bhavanasrinamthabad1809-hub/stargazing/README.md

#  Stargazing

**A panda-shaped task clock that nags me when it's time to start, yells when time's up, and gives me a star if I actually did the thing.**

## Why I made this

I am a professional procrastinator.

I don't mean "oh, I put things off a little." I mean I sit down to read a book for 30 minutes, and somehow it is two hours later and I have watched a video about how bridges are built. Phone alarms don't work on me, because I swipe them away without even waking up properly. To-do apps don't work either, because opening an app is already a task I'm avoiding.

So I asked myself: what if the thing that nags me was a *physical object* that sits on my desk, can't be swiped away, and is kind of cute so I don't hate it?

That's Stargazing. Every task has a **start time** and a **deadline**. At the start time it beeps at me. At the deadline it sounds an alarm. In between, I either press **DONE** and get a star in my little night sky, or I press **NOT DONE** and get nothing. It turns out I will do a surprising amount of work for a tiny pixel star.

---

## What it does

- Shows the **time and date** like a normal desk clock.
- Holds up to **10 tasks**, each with a name, a start time and a deadline.
- **Beeps at the start time** (three rising notes, repeated every minute until I press START).
- Shows a **countdown and a progress bar** while a task is running.
- Sounds a **siren at the deadline** until I press DONE or NOT DONE.
- Adds a **star to my star sky** for every task I finish, and the stars are saved even when it's unplugged.
- Lets me **add tasks from my phone** over Wi-Fi, with no app to install.
- Keeps the correct time even when the power is off, thanks to a battery-backed clock chip.
- Repeats my tasks every day, so I only have to type them in once.

**The three buttons** (left to right on the panda's belly): start not done done
Pressing `done` on the home screen shows my star sky.

---

## How it works 

1. I load my tasks from my phone 
2. The ESP32 keeps checking the time from the RTC.
3. When a task's start time arrives → **start alert**.
4. I press **START** → countdown begins.
5. When the deadline arrives → **siren**.
6. I press **DONE** ( +1) or **NOT DONE** (no star), and it moves on to the next task.

What if I ignore it?
- I never press START: after 10 minutes the task counts as **missed**.
- I ignore the siren: after 2 minutes it counts as **not done**.

(It really does not let me get away with anything. That's the point.)

###  pcb
schematic for my pcb 


pcb 


3d model of my pcb


## How the firmware works

The code is written in Arduino C++ 

**Main idea:**:

| State | What's happening | How it ends |
|---|---|---|
| WAITING | Home screen: time, date, next task | A task's start time arrives, or I press DONE to see the star sky |
| START_ALERT | Beeping, "TIME TO START" | I press START, or 10 minutes pass (missed) |
| RUNNING | Countdown and progress bar | Deadline arrives, or I press DONE / NOT DONE early |
| DEADLINE | Siren, "TIME'S UP!" | I press DONE or NOT DONE, or 2 minutes pass (not done) |
| RESULT | "GREAT JOB!" or "NOT DONE" for 3 seconds | Timer ends, back to `WAITING` |
| SKY | My stars | 5 seconds, or any button |

**cad time:**:
bottom case 



different view 



with pcb view



top case 



top view 



top back side view 



full box view 



**First time / changing tasks**
1. Unplug the clock, then plug it in **while holding START**.
2. On your phone, join the Wi-Fi **TaskClock** (password **panda1234**, you can change both in the code).
3. Open  in your browser.
4. Add your tasks (name, start, deadline) and press **Save to clock**.
5. It restarts by itself and you're done.

**Every day**
Just look at it. It will tell you what to do

## bill of materials 

| Component | Quantity | Description | Source | Price |
| --- | ---: | --- | --- | ----: |
| ESP32-C3 supermini | 1 | Microcontroller | [link](https://www.amazon.in/ESP32-Mini-Development-Board-Compatibility/dp/B0GQC8T6HV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) | $8.21 |
| OLED Display | 1 | Small display | [link](https://www.amazon.in/gp/product/B07Q7VZ716/ref=sw_img_1?smid=&psc=1) |$3.16 |
| 10K Resistor | 1 | Pull-up resistor | [link](https://robocraze.com/products/10k-resistor-pack-of-10) | $1|
| switches  | 3 | User input buttons  | [link](https://www.amazon.in/gp/product/B0D9NGL25F/ref=ox_sc_act_title_6?smid=AJ6SIZC8YQDZX&psc=1) | $3.25 |
|  buzzer | 1 | alarm  | [link](https://robu.in/product/1-month-warranty-1248/) | $0.53 |
| PCB | 1 | Custom-designed PCB | [link](https://jlcpcb.com/)  | $4|
| coin  battery | 1 | to work without the connection  | [Link](https://www.amazon.in/Microusb-Compatible-LIR2032-Rechargeable-Lithium/dp/B0DVCFHYPP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) | $4.04 |
| rtc module | 1 | time tracking | [Link](https://robu.in/product/ds3231-rtc-module-precise-real-time-clock-i2c-at24c32/) | $1.32 |
| S8050 transistor | 1 | works as a switch to buzzer | [Link]() |  |
| 1k resistor | 1 | to work without the connection  | [Link]() |  |
| jumper wires | 1 | to solder with rtc  | [Link](https://robu.in/product/male-to-female-jumper-wires-40pcs-20cm/) | $0.53 |
| 1N4148 diode | 1 | to solder with rtc  | [Link](https://robu.in/product/1n4148-multicomp-pro-1n4148-diode-ultrafast-recovery-150ma-75v-do-204ah-2-2/) | $0.16 |
| m3screws | 1 | to solder with rtc  | [Link]() |  |
| pcb case | 1 | to place pcb  | [Link](https://robu.in/product/numaker-abs-filament-pure-white-1-75-mm-1-kg/) | $8.21  |

## Made with

KiCad, Onshape, , Arduino IDE, and a lot of avoiding my homework.
