bhavanasrinamthabad1809-hub/stargazing/BOM.csv

Item | Qty | Supplier | Cost/item | Total Cost | link
fliament | 1 | robu | $8.21 | $8.21 | https://robu.in/product/numaker-abs-filament-pure-white-1-75-mm-1-kg/
esp32-c3 supermini | 1 | amazon | $4.21 | $4.21 | https://www.amazon.in/ESP32-Mini-Development-Board-Compatibility/dp/B0GQC8T6HV
buzzer | 1 | robu | $0.53 | $0.53 | https://robu.in/product/1-month-warranty-1248/
display | 1 | amazon | $3.16 | $3.16 | https://www.amazon.in/gp/product/B07Q7VZ716/ref=sw_img_1?smid=&psc=1
rtc module | 1 | robu | $1.32 | $1.32 | https://robu.in/product/ds3231-rtc-module-precise-real-time-clock-i2c-at24c32/
resistor | 1 | robu | $0.16 | $0.16 | https://robu.in/product/1n4148-multicomp-pro-1n4148-diode-ultrafast-recovery-150ma-75v-do-204ah-2-2/
pcb | 1 | jlcpcb | $4.00 | $4.00 | https://jlcpcb.com/
jumper wires | 1 | robu | $0.53 | $0.53 | https://robu.in/product/male-to-female-jumper-wires-40pcs-20cm/
resistor diode 6pin m3 screws | 1 | local vendor he dont have website | $9.00 | $9.00 | https://robu.in/product/male-to-female-jumper-wires-40pcs-20cm
Estimated total shipping | 1 |  |  | $0.00
