bhavanasrinamthabad1809-hub/stargazing/cadweek4/Part Studio 1 bottom case.step

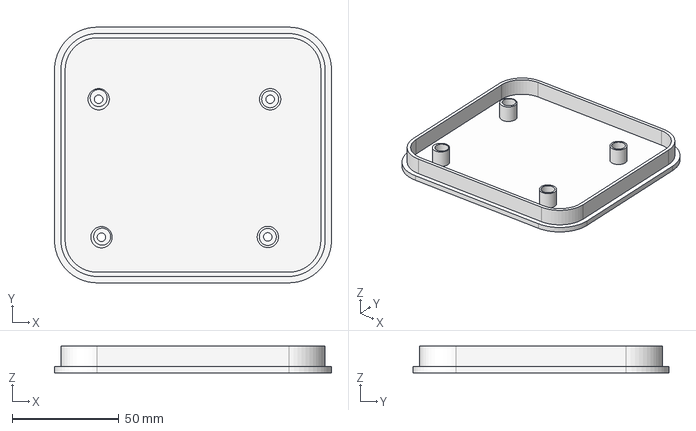
[picture p1: CAD file, 2026-11-02]
cadweek4/Part Studio 1 bottom case.step
130.0 x 120.0 x 12.6 mm
