bhavanasrinamthabad1809-hub/stargazing/procastination/procastination.step

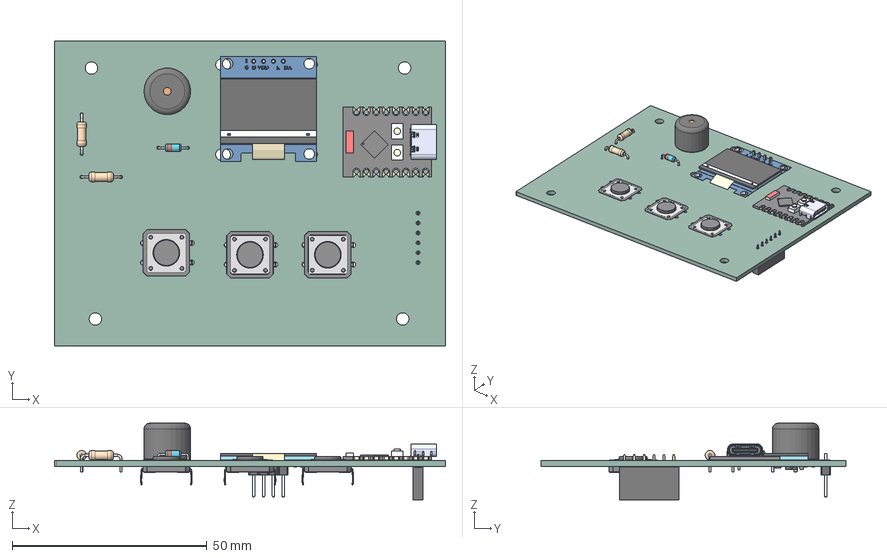
[picture p2: CAD file, 2026-11-01]
procastination/procastination.step
100.5 x 78.5 x 19.7 mm
Push Button x 3
R_Axial_DIN0207_L63mm_D25mm_P1016mm_Horizontal x 2
Board c3mini
USB C
components (other)^ESP32-C3 SuperMini
D_DO-35_SOD27_P7.62mm_Horizontal
4x1 male header pins v2
Buzzer_12x95RM76
PinSocket_1x06_P2.54mm_Vertical
pro6897_PCB
