bhavanasrinamthabad1809-hub/stargazing/cadweek4/Part Studio 1 - left ear.step

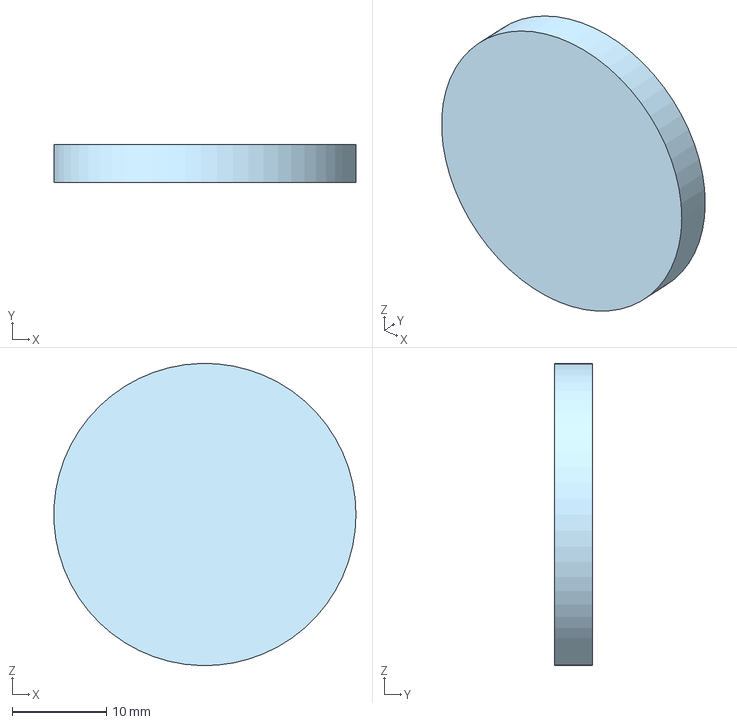
[picture p3: CAD file, 2026-11-02]
cadweek4/Part Studio 1 - left ear.step
32.0 x 4.00 x 32.0 mm
