bhavanasrinamthabad1809-hub/stargazing/cadweek4/Part Studio 1 - nose.step

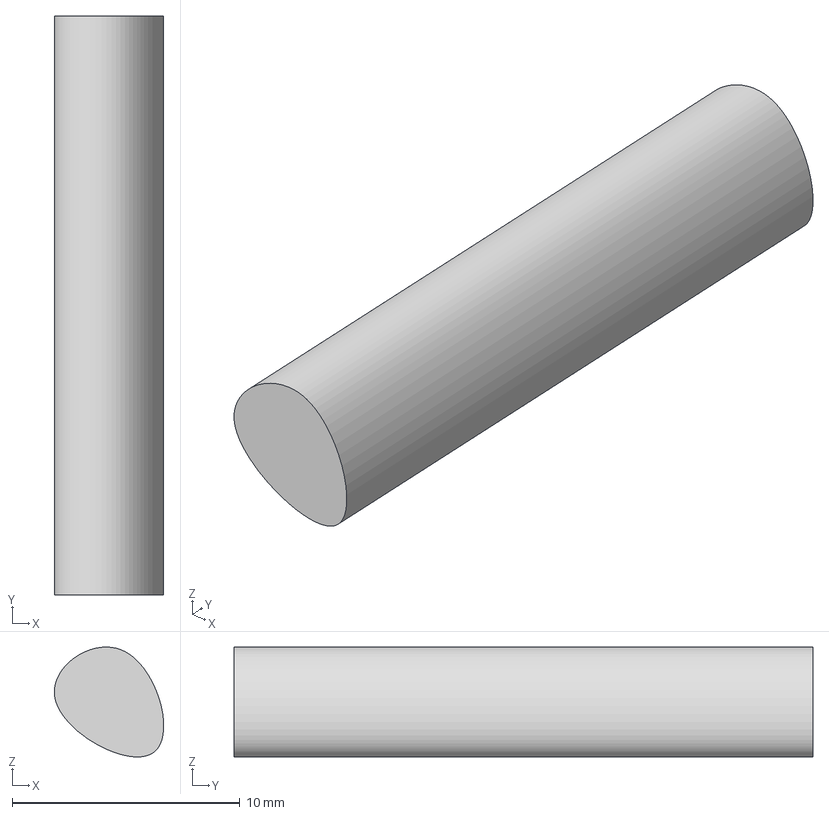
[picture p4: CAD file, 2026-11-02]
cadweek4/Part Studio 1 - nose.step
4.80 x 25.4 x 4.82 mm
