bhavanasrinamthabad1809-hub/stargazing/cadweek4/Part Studio 1 - eye.step

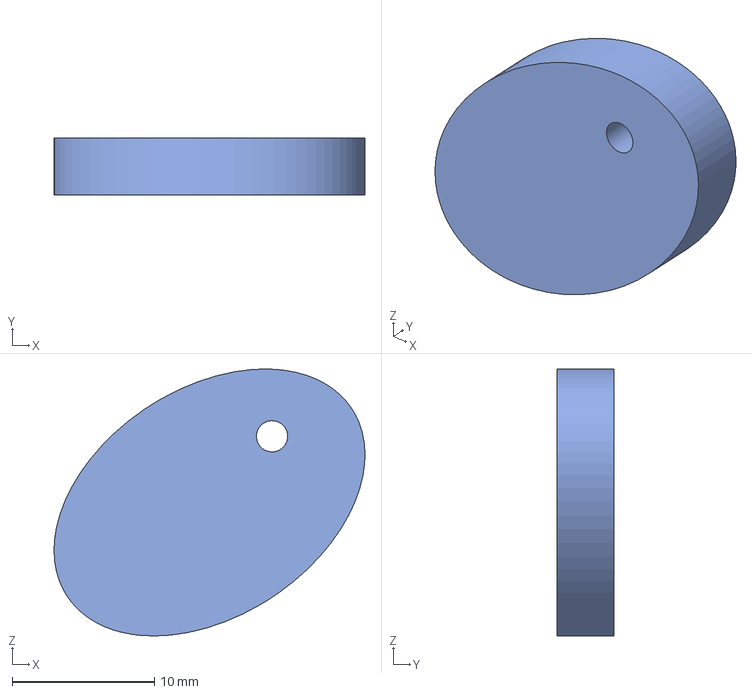
[picture p5: CAD file, 2026-11-02]
cadweek4/Part Studio 1 - eye.step
21.9 x 4.00 x 18.8 mm
