bhavanasrinamthabad1809-hub/stargazing/cadweek4/Part Studio 1 - top case.step

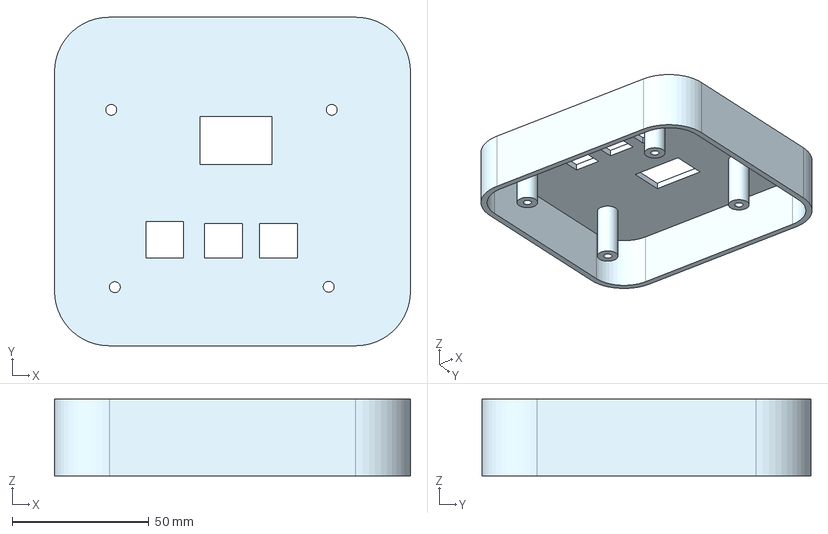
[picture p6: CAD file, 2026-11-02]
cadweek4/Part Studio 1 - top case.step
130.0 x 120.0 x 28.0 mm
