bhavanasrinamthabad1809-hub/stargazing/cadweek4/Part Studio 1 - eye2.step

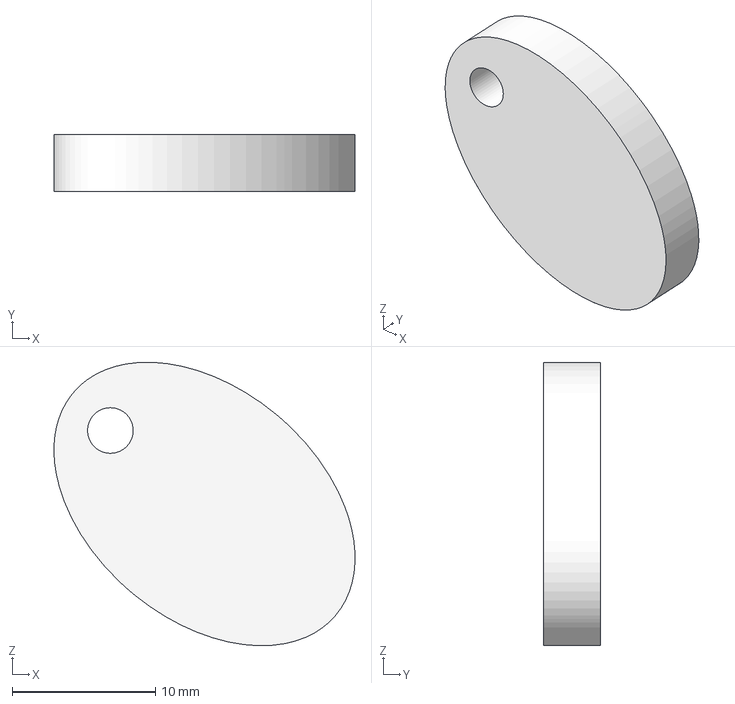
[picture p7: CAD file, 2026-11-02]
cadweek4/Part Studio 1 - eye2.step
21.0 x 4.00 x 19.8 mm
