bhavanasrinamthabad1809-hub/stargazing/(list of files, cad)

Other CAD files:
cadweek4/Part Studio 1 - right ear.step
