bhavanasrinamthabad1809-hub/stargazing/procastination/procastination.kicad_pcb

## KiCad design procastination/procastination.kicad_pcb (2026-11-01)

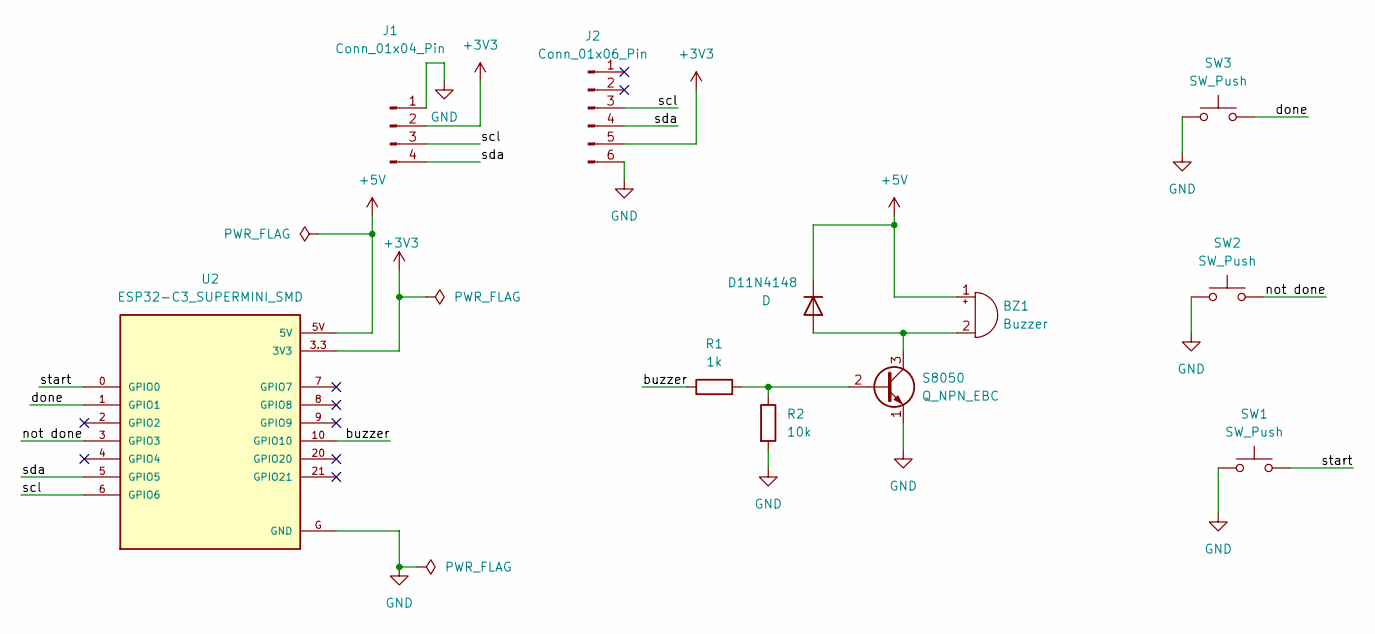
[picture p8: schematic procastination.kicad_sch]

Parts:
BZ1: Buzzer; Buzzer_12x9.5RM7.6
D11N4148: D; D_DO-35_SOD27_P7.62mm_Horizontal
J1: Conn_01x04_Pin; Display_128x64_096_I2C
J2: Conn_01x06_Pin; PinSocket_1x06_P2.54mm_Vertical
R1: 1k; R_Axial_DIN0207_L6.3mm_D2.5mm_P10.16mm_Horizontal
R2: 10k; R_Axial_DIN0207_L6.3mm_D2.5mm_P10.16mm_Horizontal
S8050: Q_NPN_EBC; TO-92_Inline
SW1, SW2, SW3: SW_Push; SW_PUSH-12mm
U2: ESP32-C3_SUPERMINI_SMD; MODULE_ESP32-C3_SUPERMINI

Connections:
+3V3: J1.2, J2.5, U2.3.3 (3V3)
+5V: BZ1.1 (+), D11N4148.1 (K), U2.5V
/buzzer: R1.1, U2.10 (GPIO10)
/done: SW3.2, U2.1 (GPIO1)
/not done: SW2.2, U2.3 (GPIO3)
/scl: J1.3, J2.3, U2.6 (GPIO6)
/sda: J1.4, J2.4, U2.5 (GPIO5)
/start: SW1.2, U2.0 (GPIO0)
GND: J1.1, J2.6, R2.2, S8050.1 (E), SW1.1, SW2.1, SW3.1, U2.G (GND)
unnamed: BZ1.2 (-), D11N4148.2 (A), S8050.3 (C)
unnamed: R1.2, R2.1, S8050.2 (B)

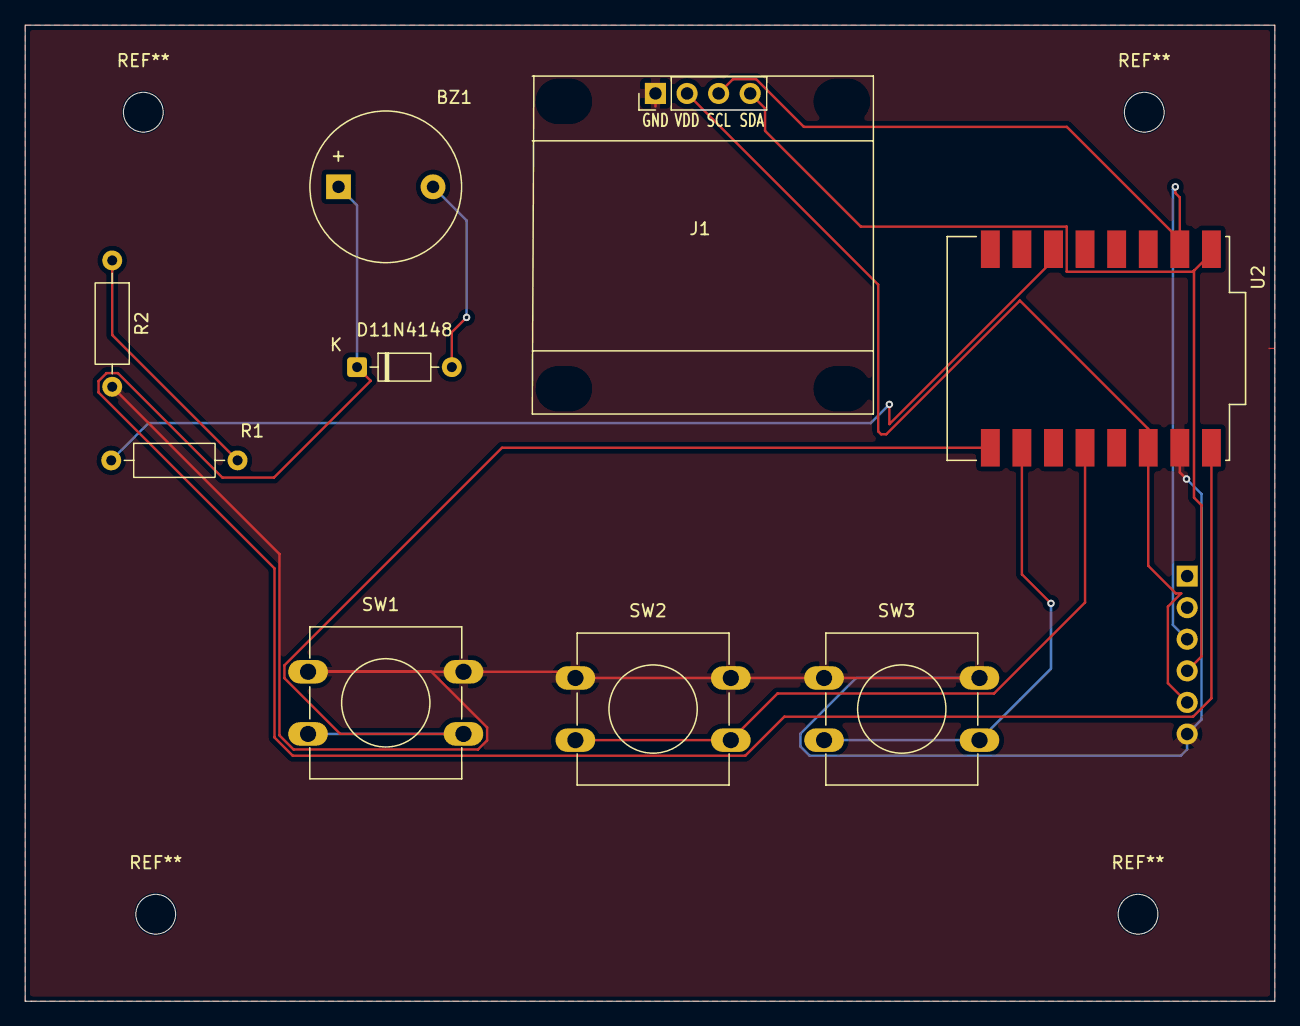
[picture p9: board procastination.kicad_pcb from above]

Board: 2 copper layers, 100.5 x 78.5 mm, 10 parts (1 on the bottom side), 11 nets.
