bhavanasrinamthabad1809-hub/stargazing/JOURNAL.md

# stargazing: devlog

<!-- Generated by Half Life from project mkkuo55vwyeqiyb1l0p5zo92. Edits here are overwritten on the next sync. -->
<!-- Generated: 2026-11-01T17:46:05.977Z -->

> [!NOTE]
> This devlog is mirrored from [Half Life](https://halflife.hackclub.com) ([open the project](https://halflife.hackclub.com/projects/mkkuo55vwyeqiyb1l0p5zo92)). Editing it here will not change the platform's copy, and the next sync overwrites this file.

> i love  stars  skys moons well i choosed star as a reward its about procrastination you can give me gold medal when the topic is this so remind i will write deadlines for my task everyday buzzer makes me remember in starting and ending there will be three buttons start done not done if you press done star gets added to my sky when click on the star it shows what task you worked at what time

| Week | Tier | Hours logged | Entries |
| --- | --- | --- | --- |
| Week 4 | Tier 1 | 16.57h | 3 |

## Contents

1. [2026-10-31: yahh finally entry 1](#2026-10-31-yahh-finally-entry-1)
2. [2026-10-31: yahhh entry 2 so far](#2026-10-31-yahhh-entry-2-so-far)
3. [2026-11-01: did the cad](#2026-11-01-did-the-cad)

## Design

### 2026-10-31: yahh finally entry 1

**6.72h**

yahh finally entry 1

first ever fully custom hardware project

i wrote my plan on notebook and planned my animal for the cad which is panda cause who gonna represent lazy ness more than panda

things i know before starting research was i need 3 buttons buzzer microcontroller display  i know but which microcontroller i have no idea so went through all got to know esp32 as many items so i choosed esp32-c3 supermini-smd

since it is time related i got to know we have to add rtc which checks time in real then resistor transistor then also diaode

biggest question in my head how we know scl sda should connect to exact gpi04



used this as rtc module



this and more some research about alot of questions in my head

then i jumped to kicad to start schematic started arranging all the parts on schematic transistor buzzer and all

then started arranging the footprints then footprint was done

then pcb arranging i went for simple rectangle cause i wanted to do cad this week

and guess what for the first time i was done with pcb route in 1hr lol

i added 3d model  gnd all done i was so happy i was done in less time i could give cad more time this week

then i asked a question in slack how can i export 3d model to cad

then i realised i did huge mistake

journal 2 continue

[Timelapse](https://lookout.hackclub.com/api/media/2e56395e-0806-40a0-888d-7173b01b6ad6/video.mp4)

[Timelapse](https://lookout.hackclub.com/api/media/5290328e-0828-425a-a794-353fb18b5e55/video.mp4)

[Timelapse](https://lookout.hackclub.com/api/media/9ddb1f4e-3a4f-44a9-9108-0360e1f1377a/video.mp4)

[Timelapse](https://lookout.hackclub.com/api/media/9460606f-ec29-4d16-bf94-a4a775d2f76c/video.mp4)

[Timelapse](https://lookout.hackclub.com/api/media/f740b5c3-4d62-4a14-bf84-cb4f5dc79daa/video.mp4)

[Timelapse](https://lookout.hackclub.com/api/media/2b25379c-2ec1-4420-958d-5186e752844e/video.mp4)

[Timelapse](https://lookout.hackclub.com/api/media/7e865e3b-3b25-46bc-be98-bd9ecc0ae570/video.mp4)

[Timelapse](https://lookout.hackclub.com/api/media/9cae96a1-a34d-4c9c-9387-c204dcf3a42a/video.mp4)

[Timelapse](https://lookout.hackclub.com/api/media/f74cead8-0e0a-46a5-9f2d-c1c424f18697/video.mp4)

[Timelapse](https://lookout.hackclub.com/api/media/c8d6f48c-bd23-4b5c-aece-e1343c573231/video.mp4)

[Timelapse](https://lookout.hackclub.com/api/media/2f28002f-7d62-4bc6-a67f-0390acf6e066/video.mp4)

[Timelapse](https://lookout.hackclub.com/api/media/91175ec4-01f6-4731-a4f7-695fa9f9cc98/video.mp4)

[Timelapse](https://lookout.hackclub.com/api/media/257f35f2-537d-492e-babc-d910f4b29267/video.mp4)

[Timelapse](https://lookout.hackclub.com/api/media/d51976d9-db05-4f09-a3fa-f4a51289dac4/video.mp4)

[Timelapse](https://lookout.hackclub.com/api/media/3312efc5-9d6e-4d9b-a57f-7e92f3432b64/video.mp4)

[Timelapse](https://lookout.hackclub.com/api/media/4a53d05b-2eb0-4a52-8773-37aa26d50db2/video.mp4)

### 2026-10-31: yahhh entry 2 so far

**3.53h**

yahhh entry 2 so far

so i asked a question in slack asking how can i import my pcb to cad so someone said you can export form file there and add on

i was yoo that so simple i can do it and then he asked whats your project idea i was typing my idea when i was typing i was using the word display and then i see the pcb there is no display hell i realised the

mistake i made that happiness vanished in 1 hr and the person who helped also made led matrix mistake he also did whole thing again lol

its kinda cry together situation i should assign display as footprint which gonna change layout and everything so start process all again from footprint

then happens one more prb that is





here is where i got 30 min lapse i did not record

i added my footprint from files from home from  every way but it just does not show up then i used full footprints then full scroll down then it showed

then added correct footprint also added mounting holes for cad

then again pcb route and errors warnings all fixed then moved to cad again

cad designing the front phase know more work there

there is still 3-4 hours of work in cad then flimware then github

[Timelapse](https://lookout.hackclub.com/api/media/297c2636-f969-479a-aba2-01ca34bb4bf4/video.mp4)

[Timelapse](https://lookout.hackclub.com/api/media/380386ee-7938-4675-8488-e9905d5e0acb/video.mp4)

[Timelapse](https://lookout.hackclub.com/api/media/ea2967ff-3ec4-4a62-afee-13c26f2e623a/video.mp4)

[Timelapse](https://lookout.hackclub.com/api/media/5061b631-036a-4eae-b250-c0feea068c7e/video.mp4)

[Timelapse](https://lookout.hackclub.com/api/media/55db9b2c-63d0-4982-af78-316d2cab7a53/video.mp4)

[Timelapse](https://lookout.hackclub.com/api/media/c033498a-0bc3-473e-b63e-fa7e6e0e2588/video.mp4)

### 2026-11-01: did the cad

**6.32h**

did the cad

when i was exporting the pcb from kicad to onshape it should be like whole of one part right but it was

so it like composite part i had to it manually select every part then it became like one part

then used transform tool to place wherever i wanted

then started designing in cad

github repo and bom time also added readme took alot of time to write

eyes nose ears are like design part which took so less time

it was my first time making a pcb enclosure yeah  thats y i was kinda struggling now it feels easy i dont know why took that much time

the mounting holes was the struggle cause when i was doing circle sketch it was showing as a sketch in one circle not in others i  did not realise it was already extrude i should remove it then it is simple after some time i realised i extrude them thats y it was like that

it was designed the bottom case top case the cute things as well which i wanted to add

one thing  i still need to fix is i cutted display and push buttons it should apply only for top layer not for bottom but it is applying for both cases just need to figure out that one thing and i am done with cad

white colour with black shade paint gonna be our case

then i shifted to code

i wrote the code  i forgot to lapse it in habit cause we use hackatime for code right i am sry for it

here is  the image of my code also on github



i think only testing the code can make me understand if everything gonna work

yeah thats how the code and cad both comes to an end

gonna write readme and addfiles then search for parts bom

then gonna end this project

thank you so much for reviewing my project

i hope you have great day ahead

[Timelapse](https://lookout.hackclub.com/api/media/f9b79e97-b365-46fa-a55b-c5ca81578e0f/video.mp4)

[Timelapse](https://lookout.hackclub.com/api/media/c1490270-d3e3-4937-bc5b-96ac523eb3a9/video.mp4)

[Timelapse](https://lookout.hackclub.com/api/media/29b74508-cf89-46df-a88a-24f3e0f56108/video.mp4)

[Timelapse](https://lookout.hackclub.com/api/media/646c21ec-61ee-46a8-81ef-9b130d69262c/video.mp4)

[Timelapse](https://lookout.hackclub.com/api/media/5c7ae635-8f56-40fa-b730-196d5f8f37e7/video.mp4)

[Timelapse](https://lookout.hackclub.com/api/media/5081e74c-1c7f-4f8d-9a4e-2d911398c0c7/video.mp4)
